danielkucera/tuya-esp-adapter/esp-adapter.kicad_pcb

## KiCad design esp-adapter.kicad_pcb (2021-09-08)

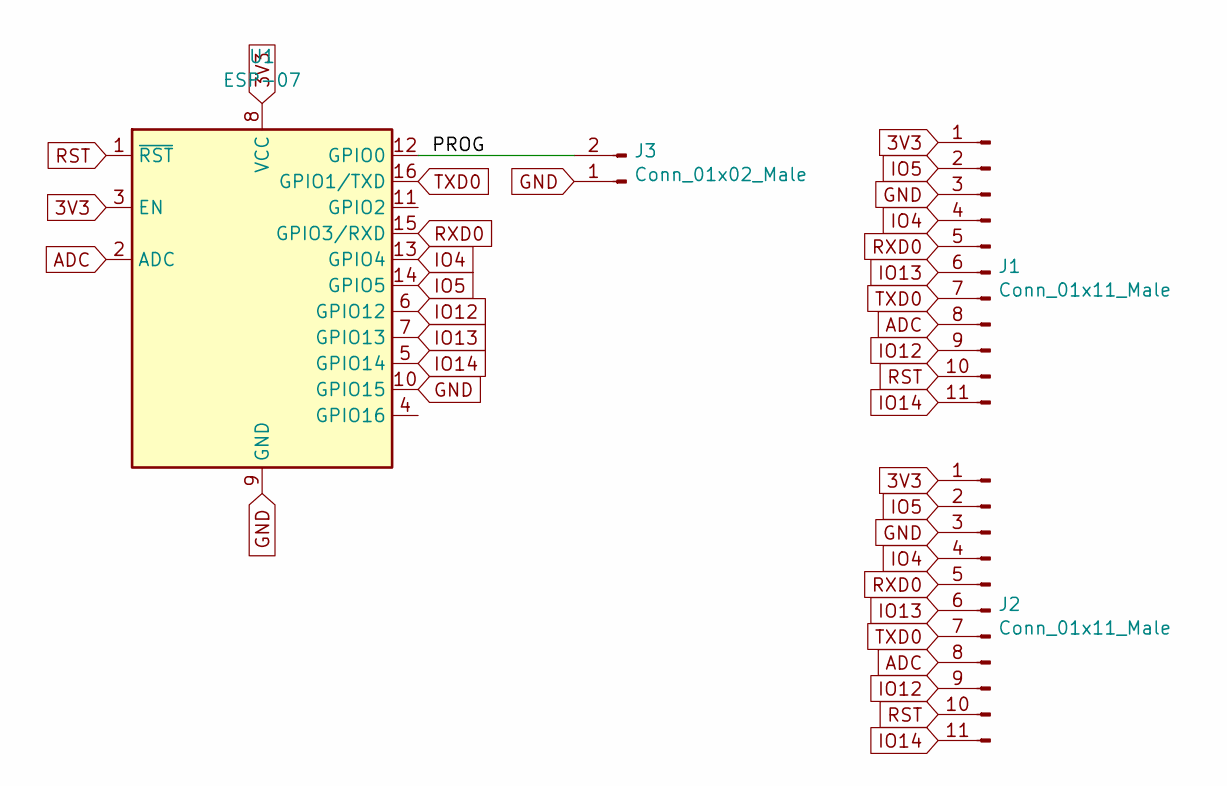
[picture p1: schematic esp-adapter.sch]

Parts:
J1: Conn_01x11_Male; edge-conn
J2: Conn_01x11_Male; PinHeader_1x11_P1.00mm_Vertical
J3: Conn_01x02_Male; PinHeader_1x02_P1.27mm_Vertical
U1: ESP-07

Connections:
3V3: J1.1, J2.1, U1.3 (EN), U1.8 (VCC)
/PROG: J3.2, U1.12 (GPIO0)
ADC: J1.8, J2.8, U1.2 (ADC)
GND: J1.3, J2.3, J3.1, U1.9 (GND), U1.10 (GPIO15)
IO4: J1.4, J2.4, U1.13 (GPIO4)
IO5: J1.2, J2.2, U1.14 (GPIO5)
IO12: J1.9, J2.9, U1.6 (GPIO12)
IO13: J1.6, J2.6, U1.7 (GPIO13)
IO14: J1.11, J2.11, U1.5 (GPIO14)
RST: J1.10, J2.10, U1.1 (~RST)
RXD0: J1.5, J2.5, U1.15 (GPIO3/RXD)
TXD0: J1.7, J2.7, U1.16 (GPIO1/TXD)

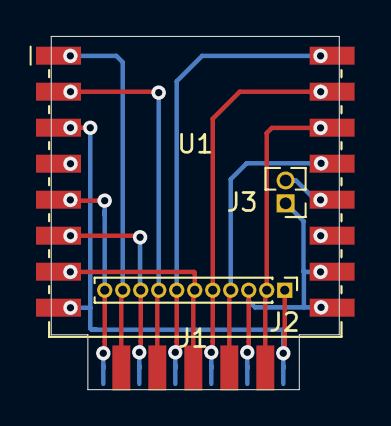
[picture p2: board esp-adapter.kicad_pcb from above]

Board: 2 copper layers, 16.0 x 19.6 mm, 4 parts (0 on the bottom side), 12 nets.
