danielkucera/tuya-esp-adapter/(threads)

Thread 1 (2021-09-08):

problem with sides of pcb

DirkTas67, 2021-09-08:
Hello,

In July I ordered this pcb you made with jlcpcb and I got a perfect pcb back, at least I thought so, I didn't notice that when ordering pcb's a jlcpcb the standard tickness is 1.6mm, too thick for the device I wanted to replace the WB2S. So I ordered them again a gew days ago and choose 0.6mm as thickness, after they send my pcb's (this one and several others) they notified me that there was a problem, they say (didn't receive the pcb yet) that the through via on the 2 sides of the pcb didn't contain copper anymore and to solve this problem I have to use 'castelated holes', the problem I have with this is that for 20 pcb's it cost 32 euro's more, this is offcourse ridiculous.

So no I want to know how I extend the pcb a bit (what layer do I have to extend) so that it is a bit bigger on the sides and they don't cut through the through via's.

Regards,
Dirk

First 1.6mm version, looks ok for me
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

comparison between the 1.6mm and the original WB2S pcb
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

danielkucera, 2021-09-08:
Hi Dirk, I have pushed an updated version to master branch. It has several fixes and doesn't require castellated holes. You can see the result in forum thread.

DirkTas67, 2021-09-20:
I Reordered them and they arrived today, and yes they fit ! Thank you, this time no problems with holes.

danielkucera, 2021-09-21:
Glad to hear that, send some photos how they fit for you.

Thread 2 (2022-01-03):

TX and RX are swapped

alyf80, 2022-01-03:
FYI,

Current master (031c61bf6d1d21104408cedd763a9be0f04462ce) has the TX and RX pins swapped; the pinout was actually correct _before_ the "fix" in that commit.
The issue is in the ESP module pinout: the pin towards the antenna should be TX, not RX.

This means the adapter will not work in any device that communicates with the ESP8266 via serial port -- e.g. anything containing a BL0940/BL0942 energy monitoring chip.

danielkucera, 2022-01-03:
Hi, I think I don't understand. I wanted it to be 1:1 compatible with TYWE2S and it has those pins vice-versa. Am I not right?

alyf80, 2022-01-03:
Looking at the KiCAD PCB file in 031c61bf6d1d21104408cedd763a9be0f04462ce, this is correct:
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

This, however, is not:
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
Pin 16 of the ESP module is TX (not RX) and pin 15 is RX (not TX).

I am using the adapter with an ESP-12F in one of [these](https://it.aliexpress.com/item/4000478798085.html), which have a serial-connected BL0942 chip and come with a [CB2S](https://developer.tuya.com/en/docs/iot/cb2s-module-datasheet?id=Kafgfsa2aaypq) module (BK7231N-based, pinout is the same as TYWE2S); energy monitoring will only work after cutting the TX/RX connections and reattaching them the other way round.

danielkucera, 2022-01-03:
But what configuration are you using for tasmota?

alyf80, 2022-01-03:
`Template{"NAME":"Elivco Power Monitoring Plug","GPIO":[0,3200,7616,7520,0,32,0,0,0,576,224,0,0,0],"FLAG":0,"BASE":18}`

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

danielkucera, 2022-01-03:
I wanted it to be compatible with this config: https://templates.blakadder.com/athom_PG01EU16A.html
In your case, you should be able to make it work with just swapping PIN1 and PIN3 config

alyf80, 2022-01-03:
In that device the ESP is interfaced to the EM chip via the SEL/CF pins -- basically the BL0937 generates a pair of pulse trains whose timing is a function of the actual voltage/current; the ESP samples them via GPIO pins and then computes energy information in software. There is no serial communication involved, so that device/configuration is not affected by this issue.

In my device, energy monitoring is done completely in the EM chip. The ESP is only connected to the BL0942 via its UART interface; every second the ESP sends a "poll" command to the BL0942 and gets back a 22-byte packet containing fully-decoded 24-bit values for voltage, current, energy and lots of other stuff. This requires a working serial connection, so it will not function if the ESP serial pins are wired incorrectly.

I can't just swap pins in the configuration -- UART TX and RX are hardware functions, and unlike GPIOs they cannot be freely reassigned on the ESP8266.

(And yes, the tasmota UI will allow you to assign "serial TX" and "serial RX" to any pin, but that's a bug in tasmota and will not result in a working configuration...)

danielkucera, 2022-01-03:
I am starting to understand. But isn't tasmota using SoftwareSerial when the pins don't match HW serial pins? So it could potentially work if you set them as I proposed. Have you tried it?

alyf80, 2022-01-03:
I had tried that, and it did not work. You are right, however: the way the BL09XX driver is written, tasmota should use a software serial implementation if neither the TX nor the RX pin matches a HW serial pin (I didn't know that!). I suspect that's because the BL0942 requires a pullup on its UART TX line, while tasmota's software serial implementation sets up the RX GPIO pin without a pullup. I'll have to look into that.

Leaving all configuration issues and workarounds aside, however, my original issue is with the hardware: right now an "adapted" ESP is not a drop-in replacement for a Tuya module, because the RX and TX pins of the ESP are swapped wrt the Tuya pinout.

danielkucera, 2022-01-03:
Good, now I am confident to revert the changes as it makes sense to me. Sorry for the inconvenience with the wrong pinout.

alyf80, 2022-01-03:
No problem and thanks for the project!

danielkucera, 2022-01-03:
You are welcome.

Closed 2022-01-03.
