danielkucera/tuya-esp-adapter/(commit log)

2021-07-07 intial commit
    [esp-adapter.kicad_pcb, esp-adapter.sch]
2021-08-03 thickness 1.0
    [esp-adapter.kicad_pcb]
2021-08-03 no castelated holes
    [esp-adapter.kicad_pcb]
2021-09-08 fabricated version
    [esp-adapter.kicad_pcb]
2021-09-08 fix TX RX swap
    [esp-adapter.kicad_pcb, esp-adapter.sch]
2022-01-03 Revert "fix TX RX swap"
    This reverts commit 031c61bf6d1d21104408cedd763a9be0f04462ce.
    For explanation see issue #2 .
    [esp-adapter.kicad_pcb, esp-adapter.sch]
